eelstretching/rp2350b-rm2-reference/docs/pcb-back.png

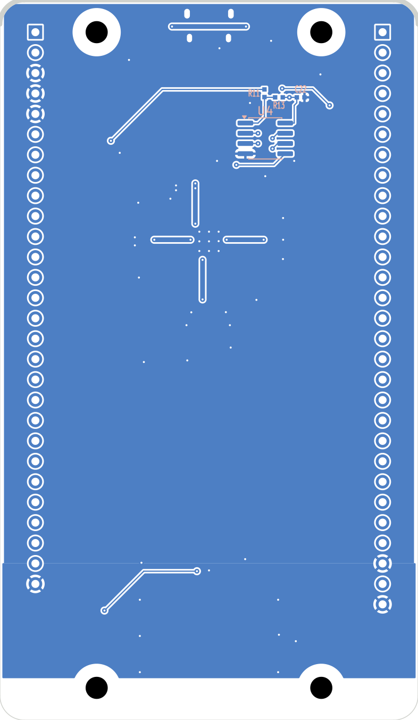
docs/pcb-back.png
