eelstretching/rp2350b-rm2-reference/docs/schematic-full.png

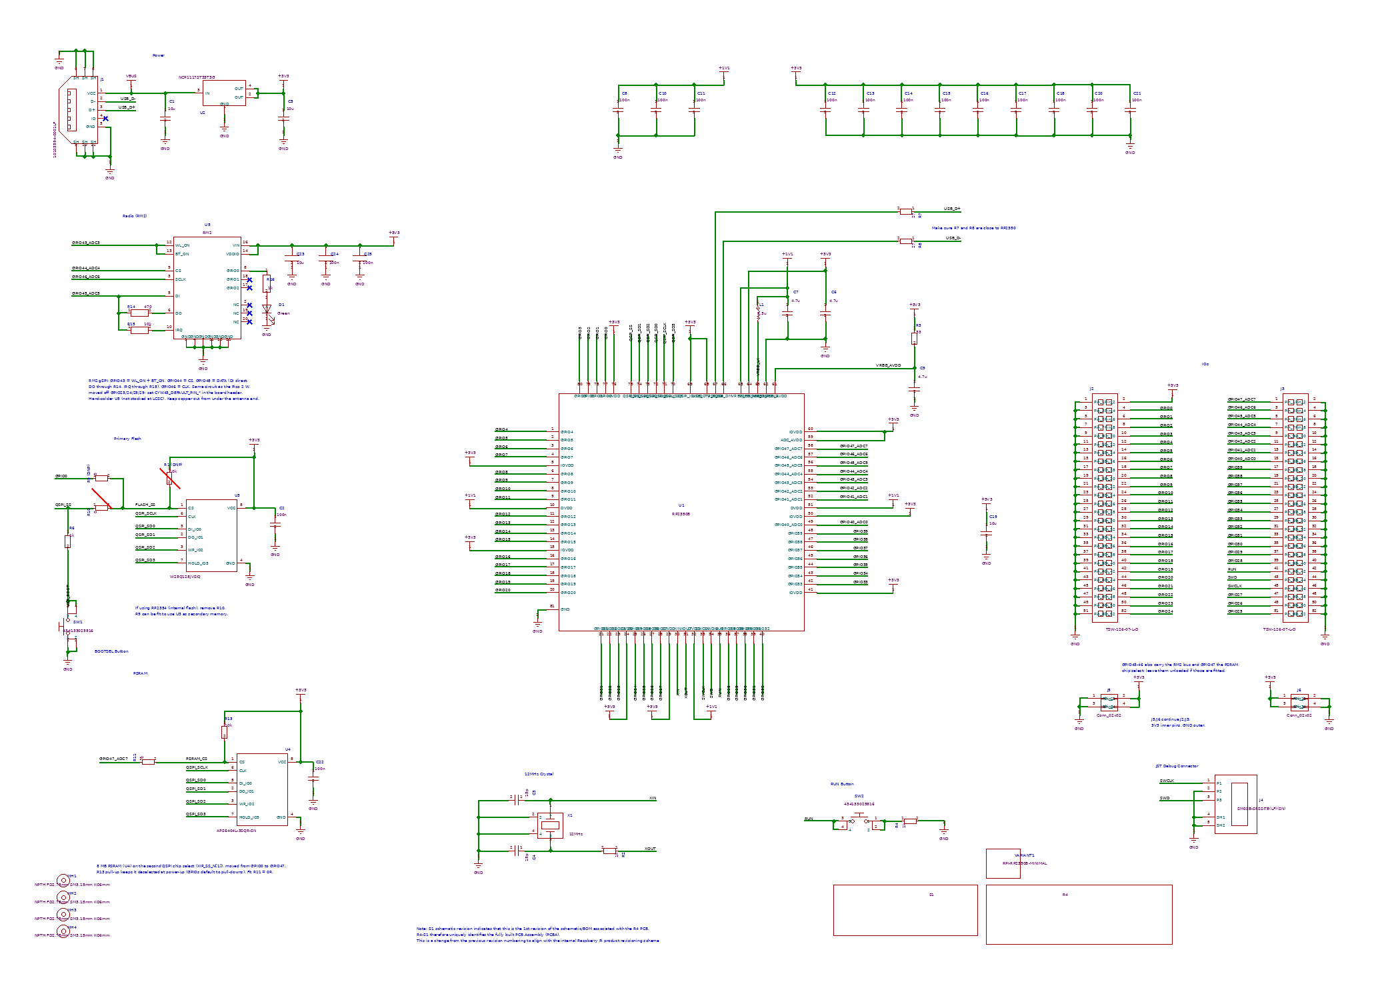
docs/schematic-full.png
