eelstretching/rp2350b-rm2-reference/docs/schematic-psram.png

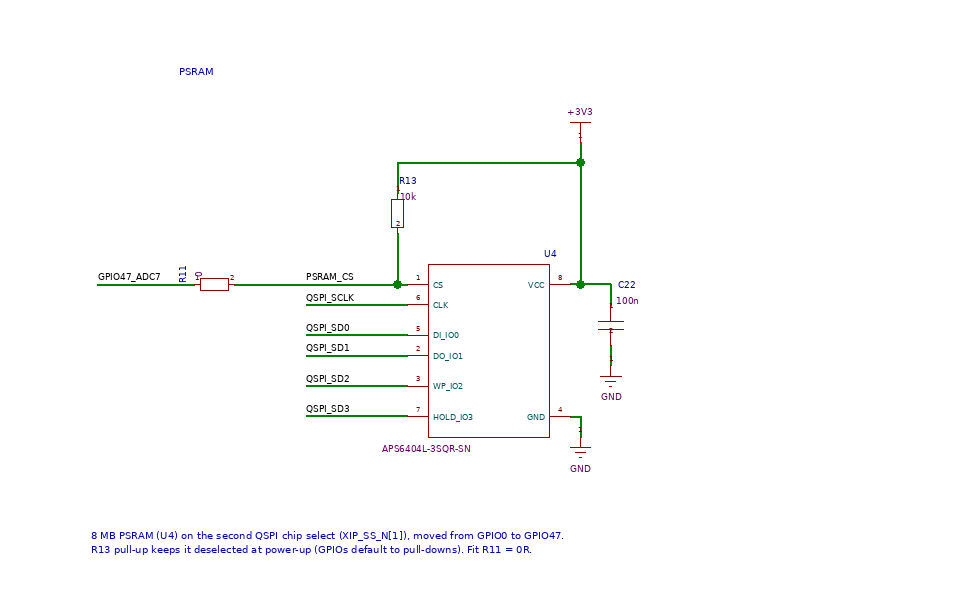
docs/schematic-psram.png
