eelstretching/rp2350b-rm2-reference/docs/schematic-radio.png

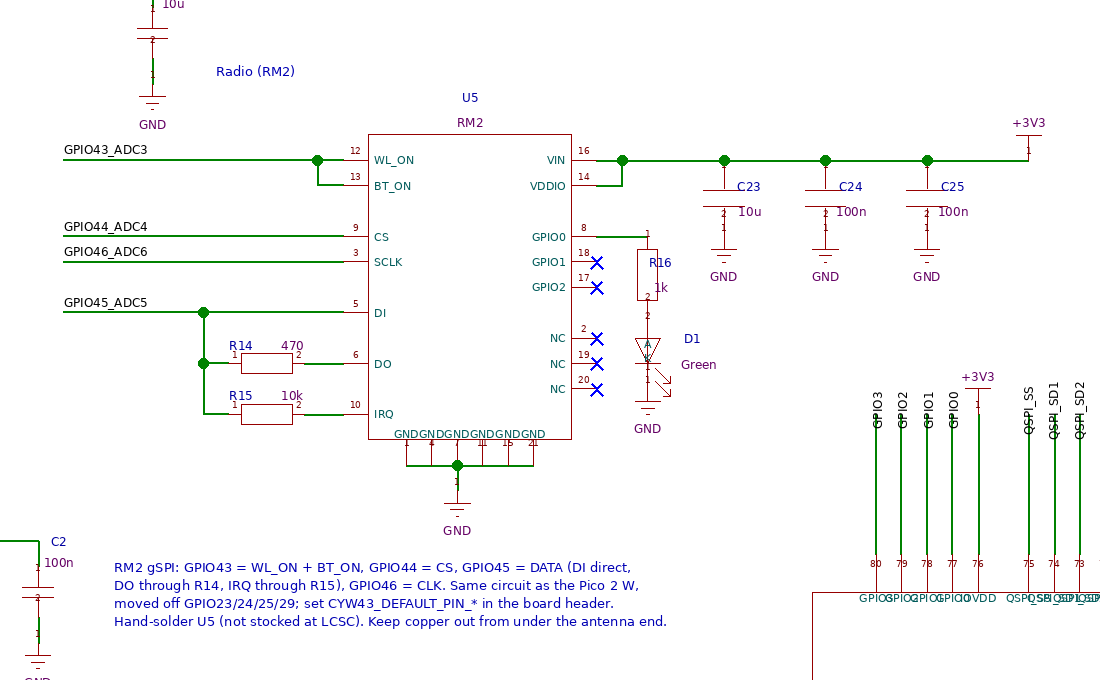
docs/schematic-radio.png
