eelstretching/rp2350b-rm2-reference/bom-jlcpcb.csv

Comment | Designator | Footprint | LCSC | Manufacturer PN | Qty | Note
10u | C1,C5,C19 | generic_capc2012x125 | C15850 | CL21A106KAYNNNE | 3
100n | C2,C8,C10,C11,C12,C13,C14,C15,C16,C17,C18,C20,C21,C22 | generic_capc1005x50 | C1525 | CL05B104KO5NNNC | 14
15p | C3,C4 | generic_capc1005x50 | C1548 | 0402CG150J500NT | 2
4.7u | C6,C7 | generic_capc1005x50_wide | C23733 | CL05A475MP5NRNC | 2
4.7u | C9 | generic_capc1005x50 | C23733 | CL05A475MP5NRNC | 1
10u | C23 | C_0805_2012Metric | C15850 | CL21A106KAYNNNE | 1
100n | C24,C25 | C_0402_1005Metric | C1525 | CL05B104KO5NNNC | 2
Green | D1 | LED_0603_1608Metric | C72043 | 19-217/GHC-YR1S2/3T | 1
10103594-0001LF | J1 | amphenol_10103594-0001lf | C428495 | 10103594-0001LF | 1
TSW-126-07-L-D | J2,J3 | samtec_tsw-126-07-l-d |  | TSW-126-07-L-D | 2 | Through-hole 2x26 2.54 mm header: hand-solder
SM03B-SRSS-TB(LF)(SN) | J4 | jst_sm03b-srss-tb-lf--sn- | C160403 | SM03B-SRSS-TB(LF)(SN) | 1
3.3u | L1 | abracon_aota-b201610s3r3-101-t | C42411119 | AOTA-B201610S3R3-101-T | 1
1k | R2,R4,R6 | generic_resc1005x35 | C11702 | 0402WGF1001TCE | 3
33 | R3 | generic_resc1005x35 | C25105 | 0402WGF330JTCE | 1
27 | R7,R8 | generic_resc1005x35 | C25100 | 0402WGF270JTCE | 2
0 | R10,R11 | generic_resc1005x35 | C17168 | 0402WGF0000TCE | 2
10k | R13 | generic_resc1005x35 | C25744 | 0402WGF1002TCE | 1
470 | R14 | R_0402_1005Metric | C25117 | 0402WGF4700TCE | 1
10k | R15 | R_0402_1005Metric | C25744 | 0402WGF1002TCE | 1
1k | R16 | R_0402_1005Metric | C11702 | 0402WGF1001TCE | 1
434133025816 | SW1,SW2 | wurthelek_434133025816 |  | 434133025816 | 2 | Not at LCSC: JLC global sourcing, or hand-solder
RP2350B | U1 | rpi_rp2350b_vias | C42415655 | RP2350B | 1
NCP1117ST33T3G | U2 | onsemi_ncp1117st33t3g | C26537 | NCP1117ST33T3G | 1
W25Q128JVSIQ | U3 | generic_soic127p790x195-8 | C97521 | W25Q128JVSIQ | 1
APS6404L-3SQR-SN | U4 | SOIC-8_3.9x4.9mm_P1.27mm | C5333729 | APS6404L-3SQR-SN | 1
RM2 | U5 | RPi_RM2 |  | SC1169 (RMC20452T) | 1 | Not at LCSC: buy RM2 (Raspberry Pi SC1169) and hand-solder
12MHz | X1 | generic_xtalcc320x250x80-4 | C20625731 | ABM8-272-T3 | 1
