eelstretching/rp2350b-rm2-reference/RP2350B-RM2.kicad_pcb

## KiCad design RP2350B-RM2.kicad_pcb (2026-10-16)

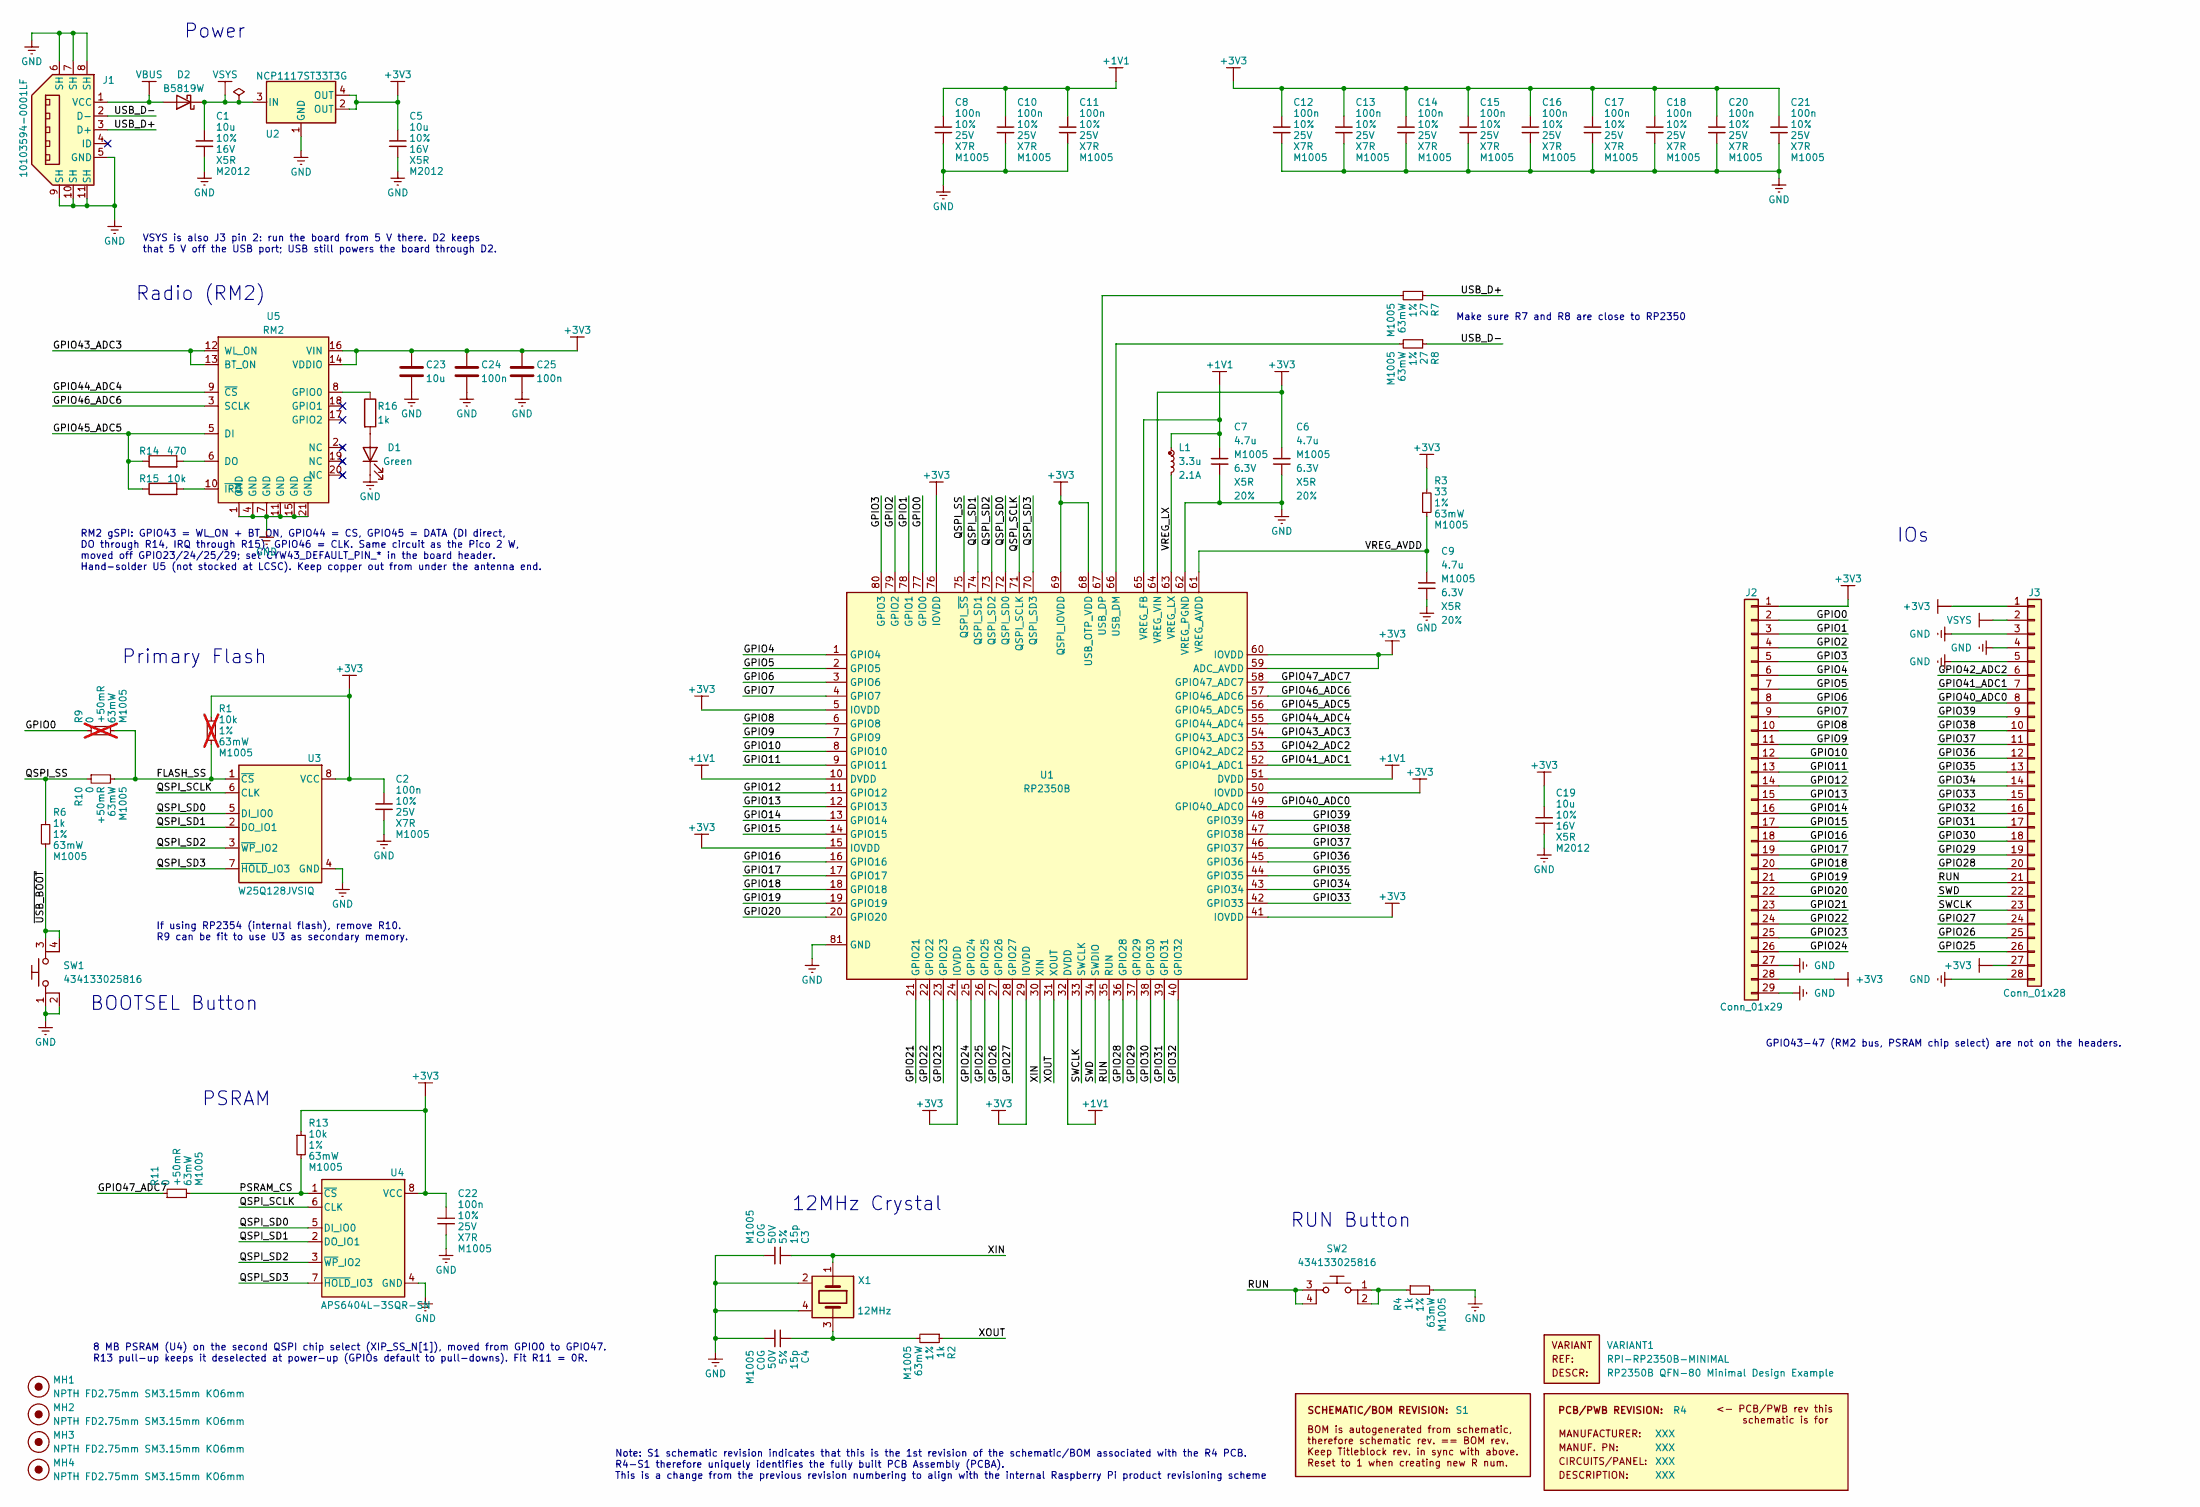
[picture p6: schematic RP2350B-RM2.kicad_sch, RP2350B + RM2 (from Raspberry Pi RP2350B Minimal Design)]

Parts:
C1, C5, C19: 10u; generic_capc2012x125; voltage 16V; tolerance 10%; part_uid RP-01GYSK-AVBE41; LCSC C15850
C2, C8, C10, C11, C12, C13, C14, C15, C16, C17, C18, C20, C21, C22: 100n; generic_capc1005x50; voltage 25V; tolerance 10%; part_uid RP-01BJ9Y-KRGF41; LCSC C1525
C3, C4: 15p; generic_capc1005x50; voltage 50V; tolerance 5%; part_uid RP-01C89W-LLY9XV; LCSC C1548
C6, C7: 4.7u; generic_capc1005x50_wide; voltage 6.3V; tolerance 20%; part_uid RP-019A1P-0C2GHY; LCSC C23733
C9: 4.7u; generic_capc1005x50; voltage 6.3V; tolerance 20%; part_uid RP-019A1P-0C2GHY; LCSC C23733
C23: 10u; C_0805_2012Metric; manufacturer_pn CL21A106KAYNNNE; LCSC C15850
C24, C25: 100n; C_0402_1005Metric; manufacturer_pn CL05B104KO5NNNC; LCSC C1525
D1: Green; LED_0603_1608Metric; manufacturer_pn 19-217/GHC-YR1S2/3T; LCSC C72043
D2: B5819W; D_SOD-123; manufacturer_pn B5819W SL; LCSC C8598
J1: 10103594-0001LF; amphenol_10103594-0001lf; part_uid RP-019A1P-1JAX7V; LCSC C428495
J2: Conn_01x29; PinHeader_1x29_P2.54mm_Vertical; manufacturer_pn 1x29 2.54 mm pin header
J3: Conn_01x28; PinHeader_1x28_P2.54mm_Vertical; manufacturer_pn 1x28 2.54 mm pin header
L1: 3.3u; abracon_aota-b201610s3r3-101-t; tolerance 20%; part_uid RP-01GY5D-2VC7WP; LCSC C42411119
MH1, MH2, MH3, MH4: NPTH FD2.75mm SM3.15mm KO6mm; none_mh_npth_fd2p75mm_sm3p15mm_ko6mm; part_uid RP-01HF5R-LCTEJS
PCB1: R4; manufacturer_pn XXX
R1: 10k; generic_resc1005x35; tolerance 1%; voltage 50V; part_uid RP-019A1P-53DHSX; LCSC C25744; not fitted
R2, R4, R6: 1k; generic_resc1005x35; tolerance 1%; voltage 50V; part_uid RP-019A1P-4Z6ZWY; LCSC C11702
R3: 33; generic_resc1005x35; tolerance 1%; voltage 50V; part_uid RP-019A1P-58PW9L; LCSC C25105
R7, R8: 27; generic_resc1005x35; tolerance 1%; voltage 50V; part_uid RP-01C89V-LTEYC4; LCSC C25100
R9: 0; generic_resc1005x35; tolerance +50mR; voltage 50V; part_uid RP-019A1P-4Y4V63; LCSC C17168; not fitted
R10, R11: 0; generic_resc1005x35; tolerance +50mR; voltage 50V; part_uid RP-019A1P-4Y4V63; LCSC C17168
R13: 10k; generic_resc1005x35; tolerance 1%; voltage 50V; part_uid RP-019A1P-53DHSX; LCSC C25744
R14: 470; R_0402_1005Metric; manufacturer_pn 0402WGF4700TCE; LCSC C25117
R15: 10k; R_0402_1005Metric; manufacturer_pn 0402WGF1002TCE; LCSC C25744
R16: 1k; R_0402_1005Metric; manufacturer_pn 0402WGF1001TCE; LCSC C11702
SBREV1: S1
SW1, SW2: 434133025816; wurthelek_434133025816; part_uid RP-01H0MT-6E9H8F
U1: RP2350B; rpi_rp2350b_vias; part_uid RP-01HA9H-ABBLJN; LCSC C42415655
U2: NCP1117ST33T3G; onsemi_ncp1117st33t3g; voltage 3.3V; part_uid RP-01JWD9-7JRX6J; LCSC C26537
U3: W25Q128JVSIQ; generic_soic127p790x195-8; voltage 2.7-3.6V; part_uid RP-01JWD4-F1H4N9; LCSC C97521
U4: APS6404L-3SQR-SN; SOIC-8_3.9x4.9mm_P1.27mm; voltage 2.7-3.6V; manufacturer_pn APS6404L-3SQR-SN; LCSC C5333729
U5: RM2; RPi_RM2; manufacturer_pn SC1169 (RMC20452T)
VARIANT1: RPI-RP2350B-MINIMAL
X1: 12MHz; generic_xtalcc320x250x80-4; tolerance 30ppm; part_uid RP-01G8X7-GS352B; LCSC C20625731

Connections:
+1V1: C7.1, C8.1, C10.1, C11.1, L1.1, U1.10 (DVDD), U1.32 (DVDD), U1.51 (DVDD), U1.65 (VREG_FB)
+3V3: C2.1, C5.1, C6.1, C12.1, C13.1, C14.1, C15.1, C16.1, C17.1, C18.1, C19.1, C20.1, C21.1, C22.1, C23.1, C24.1, C25.1, J2.1, J2.28, J3.1, J3.27, R1.1, R3.1, R13.1, U1.5 (IOVDD), U1.15 (IOVDD), U1.24 (IOVDD), U1.29 (IOVDD), U1.41 (IOVDD), U1.50 (IOVDD), U1.59 (ADC_AVDD), U1.60 (IOVDD), U1.64 (VREG_VIN), U1.68 (USB_OTP_VDD), U1.69 (QSPI_IOVDD), U1.76 (IOVDD), U2.2 (OUT), U2.4 (OUT), U3.8 (VCC), U4.8 (VCC), U5.14 (VDDIO), U5.16 (VIN)
/FLASH_SS: R1.2, R9.2, R10.2, U3.1 (~CS)
/GPIO0: J2.2, R9.1, U1.77 (GPIO0)
/GPIO1: J2.3, U1.78 (GPIO1)
/GPIO2: J2.4, U1.79 (GPIO2)
/GPIO3: J2.5, U1.80 (GPIO3)
/GPIO4: J2.6, U1.1 (GPIO4)
/GPIO5: J2.7, U1.2 (GPIO5)
/GPIO6: J2.8, U1.3 (GPIO6)
/GPIO7: J2.9, U1.4 (GPIO7)
/GPIO8: J2.10, U1.6 (GPIO8)
/GPIO9: J2.11, U1.7 (GPIO9)
/GPIO10: J2.12, U1.8 (GPIO10)
/GPIO11: J2.13, U1.9 (GPIO11)
/GPIO12: J2.14, U1.11 (GPIO12)
/GPIO13: J2.15, U1.12 (GPIO13)
/GPIO14: J2.16, U1.13 (GPIO14)
/GPIO15: J2.17, U1.14 (GPIO15)
/GPIO16: J2.18, U1.16 (GPIO16)
/GPIO17: J2.19, U1.17 (GPIO17)
/GPIO18: J2.20, U1.18 (GPIO18)
/GPIO19: J2.21, U1.19 (GPIO19)
/GPIO20: J2.22, U1.20 (GPIO20)
/GPIO21: J2.23, U1.21 (GPIO21)
/GPIO22: J2.24, U1.22 (GPIO22)
/GPIO23: J2.25, U1.23 (GPIO23)
/GPIO24: J2.26, U1.25 (GPIO24)
/GPIO25: J3.26, U1.26 (GPIO25)
/GPIO26: J3.25, U1.27 (GPIO26)
/GPIO27: J3.24, U1.28 (GPIO27)
/GPIO28: J3.20, U1.36 (GPIO28)
/GPIO29: J3.19, U1.37 (GPIO29)
/GPIO30: J3.18, U1.38 (GPIO30)
/GPIO31: J3.17, U1.39 (GPIO31)
/GPIO32: J3.16, U1.40 (GPIO32)
/GPIO33: J3.15, U1.42 (GPIO33)
/GPIO34: J3.14, U1.43 (GPIO34)
/GPIO35: J3.13, U1.44 (GPIO35)
/GPIO36: J3.12, U1.45 (GPIO36)
/GPIO37: J3.11, U1.46 (GPIO37)
/GPIO38: J3.10, U1.47 (GPIO38)
/GPIO39: J3.9, U1.48 (GPIO39)
/GPIO40_ADC0: J3.8, U1.49 (GPIO40_ADC0)
/GPIO41_ADC1: J3.7, U1.52 (GPIO41_ADC1)
/GPIO42_ADC2: J3.6, U1.53 (GPIO42_ADC2)
/GPIO43_ADC3: U1.54 (GPIO43_ADC3), U5.12 (WL_ON), U5.13 (BT_ON)
/GPIO44_ADC4: U1.55 (GPIO44_ADC4), U5.9 (~CS)
/GPIO45_ADC5: R14.1, R15.1, U1.56 (GPIO45_ADC5), U5.5 (DI)
/GPIO46_ADC6: U1.57 (GPIO46_ADC6), U5.3 (SCLK)
/GPIO47_ADC7: R11.1, U1.58 (GPIO47_ADC7)
/PSRAM_CS: R11.2, R13.2, U4.1 (~CS)
/QSPI_SCLK: U1.71 (QSPI_SCLK), U3.6 (CLK), U4.6 (CLK)
/QSPI_SD0: U1.72 (QSPI_SD0), U3.5 (DI_IO0), U4.5 (DI_IO0)
/QSPI_SD1: U1.74 (QSPI_SD1), U3.2 (DO_IO1), U4.2 (DO_IO1)
/QSPI_SD2: U1.73 (QSPI_SD2), U3.3 (~WP_IO2), U4.3 (~WP_IO2)
/QSPI_SD3: U1.70 (QSPI_SD3), U3.7 (~HOLD_IO3), U4.7 (~HOLD_IO3)
/QSPI_SS: R6.1, R10.1, U1.75 (QSPI_~SS)
/RUN: J3.21, SW2.3, SW2.4, U1.35 (RUN)
/SWCLK: J3.23, U1.33 (SWCLK)
/SWD: J3.22, U1.34 (SWDIO)
/USB_D+: J1.3 (D+), R7.1
/USB_D-: J1.2 (D-), R8.1
/VREG_AVDD: C9.1, R3.2, U1.61 (VREG_AVDD)
/VREG_LX: L1.2, U1.63 (VREG_LX)
/XIN: C3.1, U1.30 (XIN), X1.1
/XOUT: R2.1, U1.31 (XOUT)
/~USB_BOOT: R6.2, SW1.3, SW1.4
GND: C1.2, C2.2, C3.2, C4.2, C5.2, C6.2, C7.2, C8.2, C9.2, C10.2, C11.2, C12.2, C13.2, C14.2, C15.2, C16.2, C17.2, C18.2, C19.2, C20.2, C21.2, C22.2, C23.2, C24.2, C25.2, D1.1 (K), J1.5 (GND), J1.6 (SH), J1.7 (SH), J1.8 (SH), J1.9 (SH), J1.10 (SH), J1.11 (SH), J2.27, J2.29, J3.3, J3.4, J3.5, J3.28, R4.2, SW1.1, SW1.2, U1.62 (VREG_PGND), U1.81 (GND), U2.1 (GND), U3.4 (GND), U4.4 (GND), U5.1 (GND), U5.4 (GND), U5.7 (GND), U5.11 (GND), U5.15 (GND), U5.21 (GND), X1.2, X1.4
unnamed: C4.1, R2.2, X1.3
unnamed: D1.2 (A), R16.2
unnamed: R4.1, SW2.1, SW2.2
unnamed: R8.2, U1.66 (USB_DM)
unnamed: R7.2, U1.67 (USB_DP)
unnamed: R14.2, U5.6 (DO)
unnamed: R16.1, U5.8 (GPIO0)
unnamed: R15.2, U5.10 (~IRQ)
VBUS: D2.2 (A), J1.1 (VCC)
VSYS: C1.1, D2.1 (K), J3.2, U2.3 (IN)

Notes on the sheet:
8 MB PSRAM (U4) on the second QSPI chip select (XIP_SS_N[1]), moved from GPIO0 to GPIO47. R13 pull-up keeps it deselected at power-up (GPIOs default to pull-downs). Fit R11 = 0R.
IOs
If using RP2354 (internal flash), remove R10. R9 can be fit to use U3 as secondary memory.
GPIO43-47 (RM2 bus, PSRAM chip select) are not on the headers.
Note: S1 schematic revision indicates that this is the 1st revision of the schematic/BOM associated with the R4 PCB. R4-S1 therefore uniquely identifies the fully built PCB Assembly (PCBA). This is a change from the previous revision numbering to align with the internal Raspberry Pi product revisio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
Radio (RM2)
RUN Button
RM2 gSPI: GPIO43 = WL_ON + BT_ON, GPIO44 = CS, GPIO45 = DATA (DI direct, DO through R14, IRQ through R15), GPIO46 = CLK. Same circuit as the Pico 2 W, moved off GPIO23/24/25/29; set CYW43_DEFAULT_PIN_* in the board header. Hand-solder U5 (not stocked at LCSC). Keep copper out from under the antenna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
Primary Flash
BOOTSEL Button
12MHz Crystal
Make sure R7 and R8 are close to RP2350
PSRAM
Power
VSYS is also J3 pin 2: run the board from 5 V there. D2 keeps that 5 V off the USB port; USB still powers the board through D2.

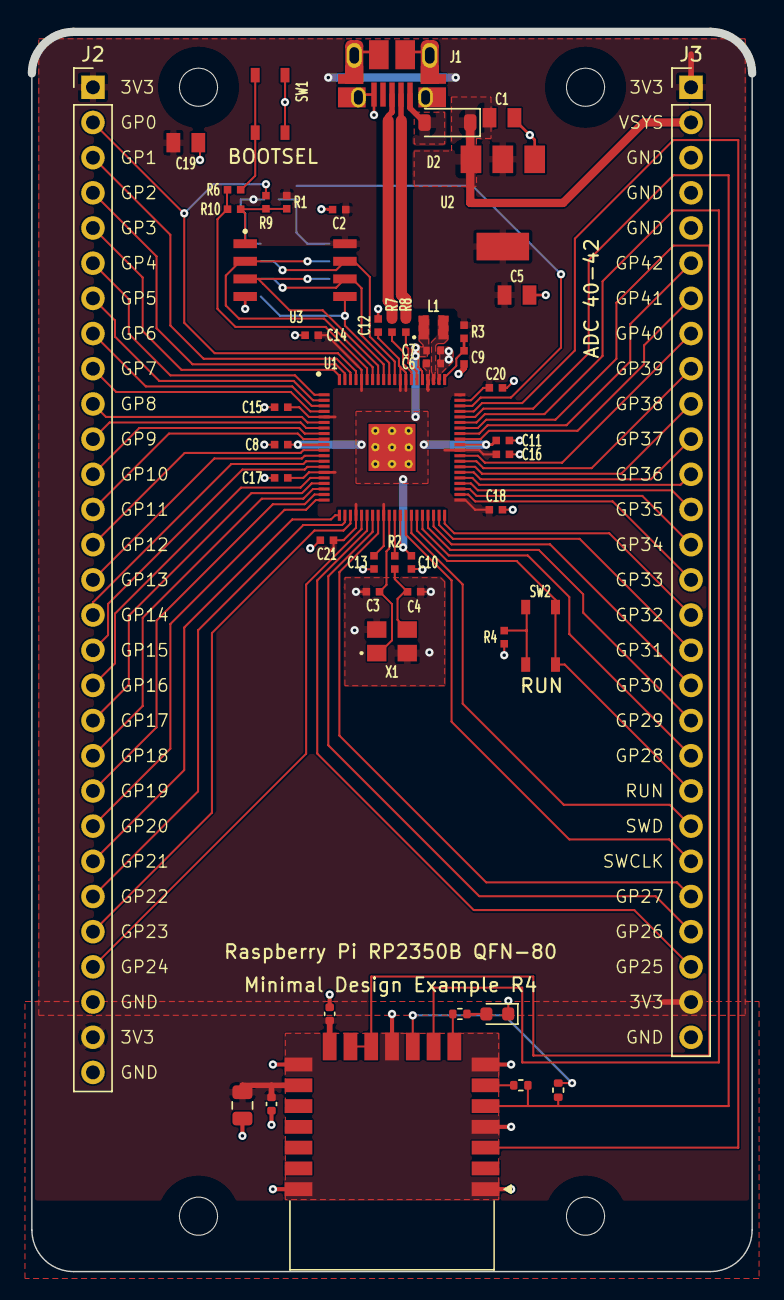
[picture p7: board RP2350B-RM2.kicad_pcb from above]

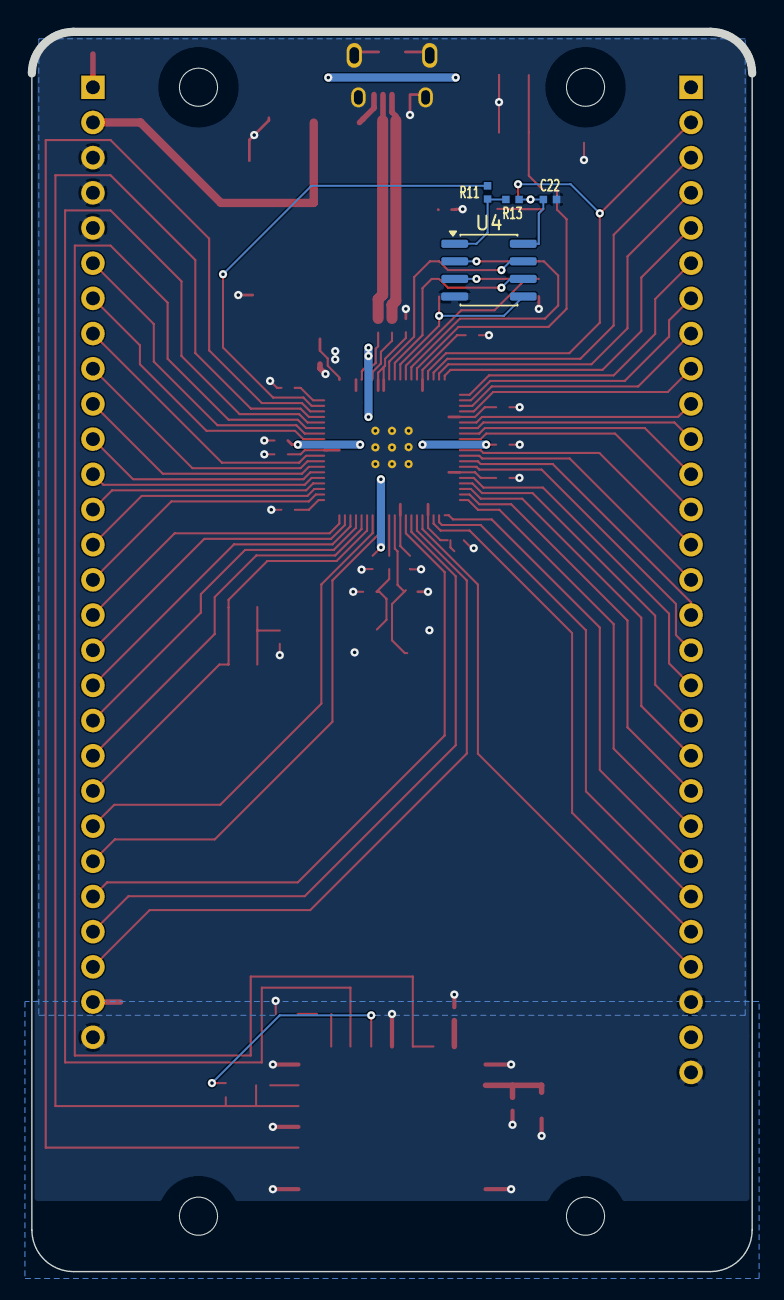
[picture p8: board RP2350B-RM2.kicad_pcb from below]

Board: 2 copper layers, 52.0 x 89.5 mm, 57 parts (4 on the bottom side), 79 nets.
