eelstretching/rp2350b-rm2-reference/(commit log)

2026-10-15 RP2350B minimal design with RM2 radio and PSRAM: schematic
    Raspberry Pi's RP2350B minimal reference (R4, MIT) with the RM2 on
    GPIO 43-46 and the APS6404L PSRAM chip select moved to GPIO47, leaving
    GPIO 0-42 free and in order. Includes JLCPCB BOM, RM2 symbol and
    footprint, pico-sdk board header and a blink bring-up test. Layout is
    still Pi's original board.
    Claude-Session: https://claude.ai/code/session_013qifTuf2cQy4rLFviQdJRS
2026-10-15 Lay out RM2 radio and APS6404L PSRAM on Pi's board
    Update PCB from Schematic (scripted, KiCad 10.0.6), then:
    - Add a 22.5 x 27.5 mm tab on the right edge for the RM2. The antenna end
    faces the tab edge, with a copper-free rule area on both layers across
    the whole antenna strip. The module has GND pours under it and a via at
    every GND pad. gSPI runs from J3's GPIO43-46 between the outer GND pins.
    3V3 comes from Pi's pour strip beside J3.
    - Swap U4 to a 150 mil SOIC-8 and replace its back-side fan-out, whose vias
    sat under the new pads.
    - Move R11 from GPIO0 to GPIO47.
    Pi's other footprints and tracks are unchanged. DRC shows 0 unconnected
    items and 0 parity issues; only Pi's RPI_C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
2026-10-16 Move the RM2 to a stretched end of the board instead of a side tab
    Drop the right-hand tab. The board keeps its 52 mm width and grows 18 mm
    at the end away from USB, as on the Pico 2 W. The RM2 sits between the
    headers there with its antenna at the new bottom edge, and a full-width
    rule area keeps copper off both layers under the antenna.
    GPIO43-46 run down J3 on the top layer, in the gap between its pin
    columns and between its GND column and the edge, where Pi has no copper.
    IRQ is the only radio signal that takes the back layer. Each GND pad
    still gets its own via. The U4 and R11 changes are as before.
    DRC: 0 unconnected items, 0 parity issues; only Pi's RPI_COMPILED
    library notes remain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
2026-10-16 Add 3V3 header extensions J5/J6 and move the bottom mounting holes
    Schematic: add J5 and J6, 2x02 headers that continue J2 and J3 by two
    rows. Each has two 3V3 pins on the inner column and two GND pins on the
    outer column, matching how J2/J3 are laid out. New footprint
    PinHeader_2x02_P2.54mm_Ext: round pads, with silkscreen that joins the
    header outline above.
    Board: J5/J6 sit on J2/J3's 2.54 mm grid with "3V3" labels in Pi's
    style. The WL_ON and CS lanes now turn below them, and J6's 3V3 pins get
    a track into the pour. MH3/MH4 move to the new end, in line with the top
    pair and 4 mm from the edge, so the holes form a 27.94 x 81.5 mm
    rectangle. The antenna rule area allows the NPTH holes.
    D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
2026-10-16 Restore CRLF line endings in bom-jlcpcb.csv
    Claude-Session: https://claude.ai/code/session_01TVxWe2rd4mhh6Q8D57QZer
2026-10-16 README: add notes on using the board on perfboard
    Which header pins to fit, socketing and wiring on the underside,
    clearance for the underside parts, keeping the antenna end clear, and
    the stripboard and breadboard pitfalls (GND and signal or 3V3 pins
    sharing a strip).
    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
2026-10-16 Add psram_test bring-up example and a psram_alloc heap library
    firmware/psram_test: brings up the 8 MB APS6404L (U4, CS on GPIO47)
    through pico-sdk 2.3.0's hardware_psram using the board header's
    constants. It runs data-bus and address-bus tests, then three
    full-chip fill/verify passes: two uncached and one written through the
    XIP cache and cleaned. It prints cached throughput, exercises the heap,
    and repeats the PASS/FAIL verdict on USB/UART stdio.
    firmware/psram_alloc: psram_malloc/calloc/realloc/memalign/free and
    psram_heap_stats over the PSRAM left after any __in_psram variables.
    It uses TLSF (vendored, BSD-3-Clause) with its control block in SRAM,
    gives 8-byte alignment (TLSF alone onl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
2026-10-16 Single-row J2/J3 headers with 3V3 and GND at the ends
    Replace Pi's 2x26 headers (outer column all GND) and the J5/J6
    extensions with single-row headers on Pi's signal columns:
    J2 (1x29): 3V3, GPIO0-24, GND, 3V3, GND
    J3 (1x28): 3V3, 3V3, GND x3, GPIO42-28, RUN, SWD, SWCLK,
    GPIO27-25, 3V3, GND
    GPIO43-47 leave the header, since the radio and PSRAM need them.
    Schematic: new Conn_01x29 / Conn_01x28 symbols sit exactly on the old
    signal-pin positions, so every GPIO label connection carries over.
    The GND buses, J5/J6 and the GPIO43-47 header hookups are removed.
    Board: stock PinHeader_1x29/1x28 footprints on the same pads, so Pi's
    routing to every GPIO is untouched. Pi's GPIO43-4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
2026-10-16 Remove the J4 debug connector; route SWD/SWCLK straight to J3
    SWD and SWCLK are on J3 (pins 22/23, next to RUN), so the JST debug
    connector is redundant.
    Schematic: J4, its wiring, its GND symbol and the "JST Debug Connector"
    heading are removed. SWD/SWCLK keep their labels at U1 and J3.
    Board (edited on top of the refilled board): J4, its GND stubs and two
    vias, and the "DEBUG" silkscreen are removed. Pi ran SWD and SWCLK
    through J4's pads; they now continue along the same 45-degree lines
    into their existing horizontal runs to J3. Zones refilled.
    Pipeline: update_pcb_from_sch.py now deletes footprints whose symbol is
    gone, and layout_rm2.py has the matching J4 section. Re-running both fr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
2026-10-16 Add a 5 V VSYS input on J3 pin 2, with USB VBUS through a Schottky
    J3 pin 2 (was a second 3V3 pin) is now VSYS, the input of the 3.3 V
    regulator, so the board can run from 5 V on the header without USB.
    USB VBUS reaches VSYS through D2 (B5819W, SOD-123), so header power
    can't back-feed a connected computer, as on a Pico.
    - Schematic: D2 between VBUS and VSYS, a VSYS power symbol and a
    PWR_FLAG; J3 pin 2's power symbol is VSYS.
    - PCB: D2 sits between J1, C1 and U2. Pi's VBUS pour is split into a
    USB side (J1 to D2's anode) and VSYS. A 0.6 mm VSYS track runs from
    D2's cathode through U2's input pad, under U2 and up to J3 pin 2, so
    the 3V3 pour around J3 pin 1 stays joined to U2's outp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
